hutscape/palm/readme.md

# Palm

> 🌴 Outdoor BLE-connected UV sensor keychain 🗝

Visit [hutscape.com/palm](https://hutscape.com/palm/) for more details.

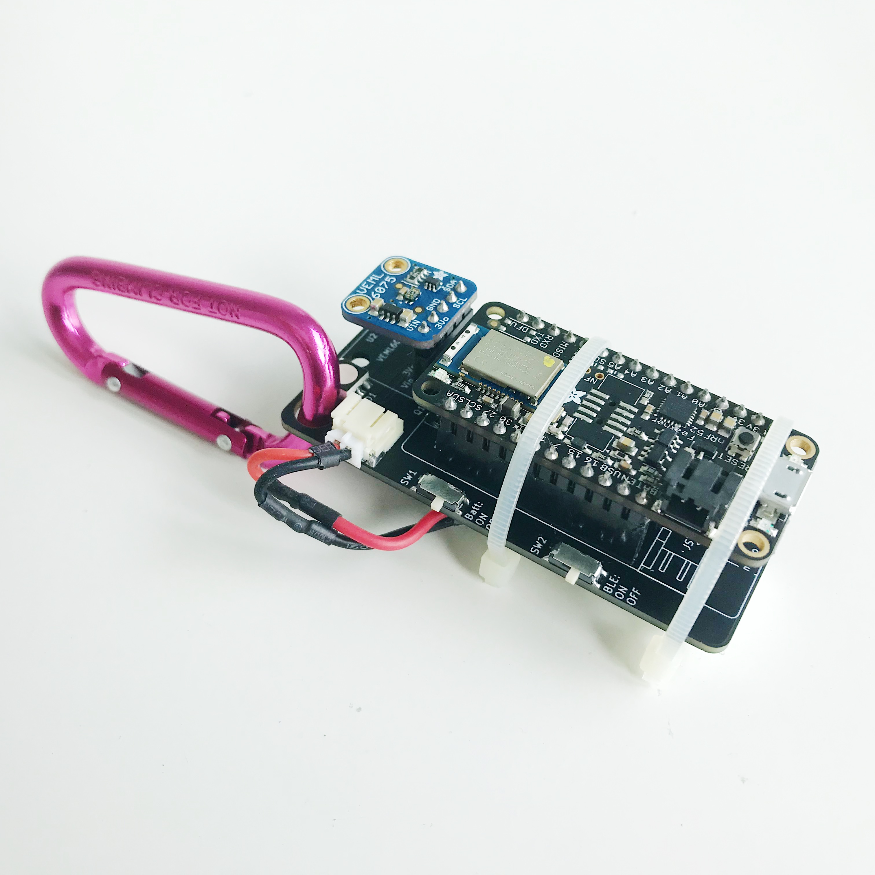
[picture p1: images/prototype/front.jpg]
