hutscape/palm/_code/web-ble.md

---
layout: code
title: Web BLE
description: Web BLE on Chrome browser is used to display the UV Index and Battery level on laptop
difficulty: medium
features:
  - UV
  - BLE
  - Chrome
  - browser
  - html
code: html
---
