hutscape/palm/images/code/demo-console.png

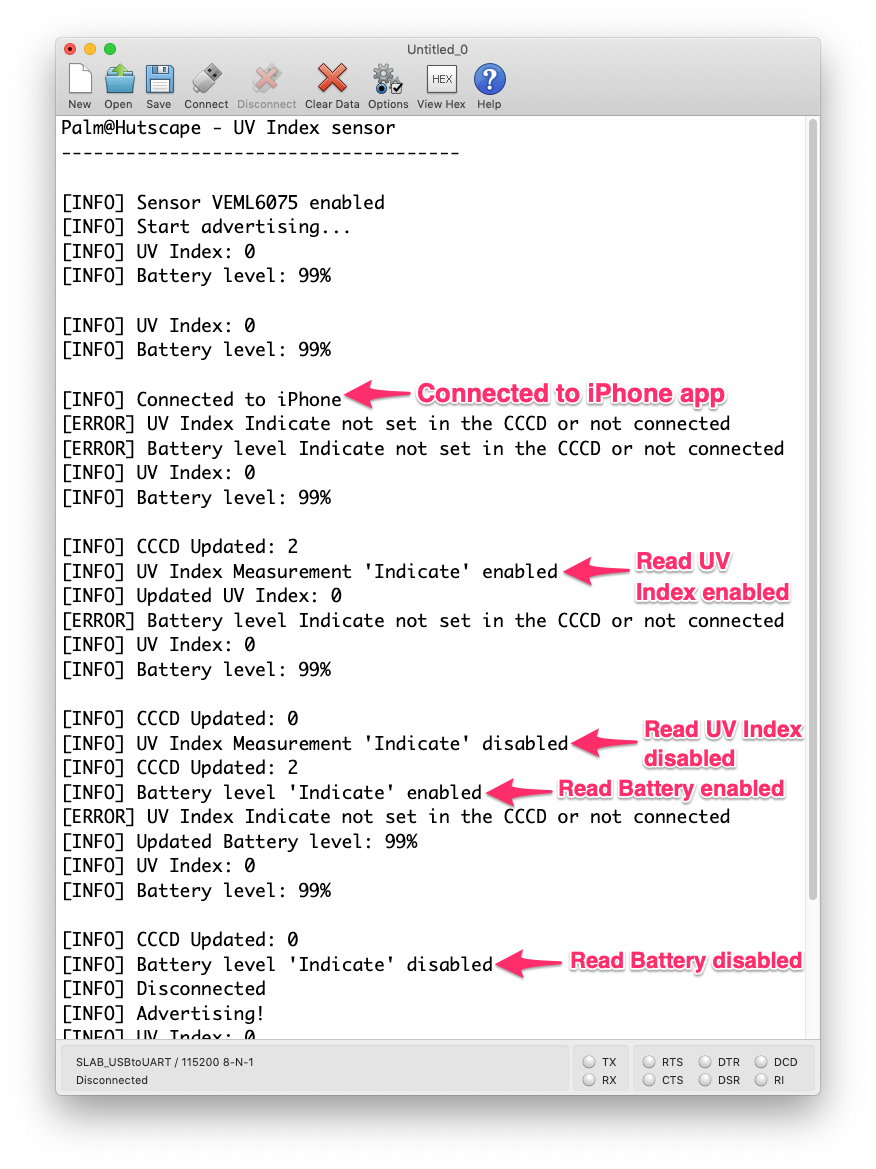
images/code/demo-console.png
