hutscape/palm/images/pcb/3dview-back.png

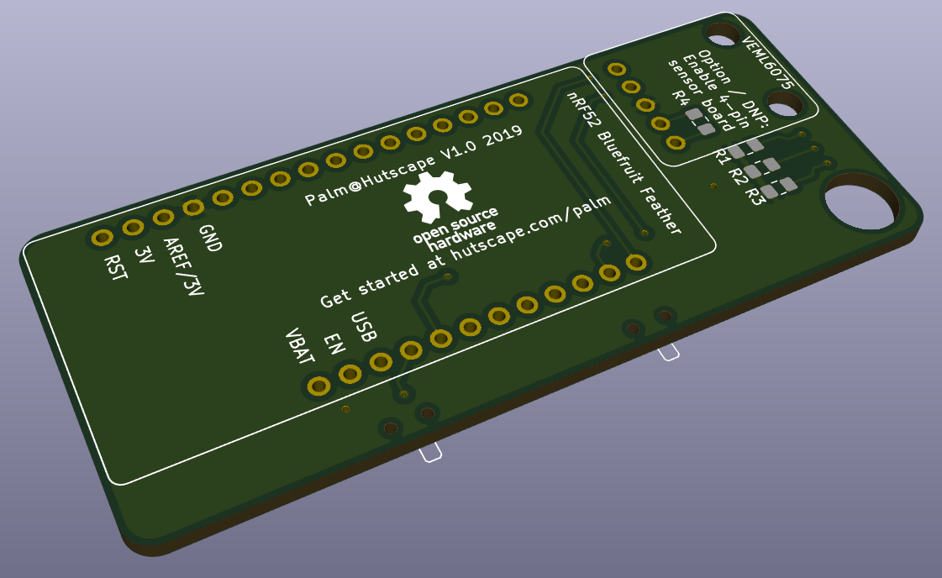
images/pcb/3dview-back.png
