hutscape/palm/images/pcb/layout-back.png

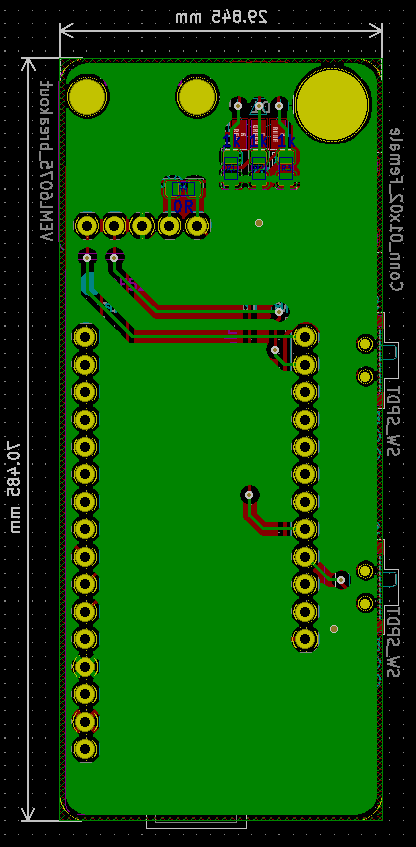
images/pcb/layout-back.png
