hutscape/palm/images/pcb/schematic.png

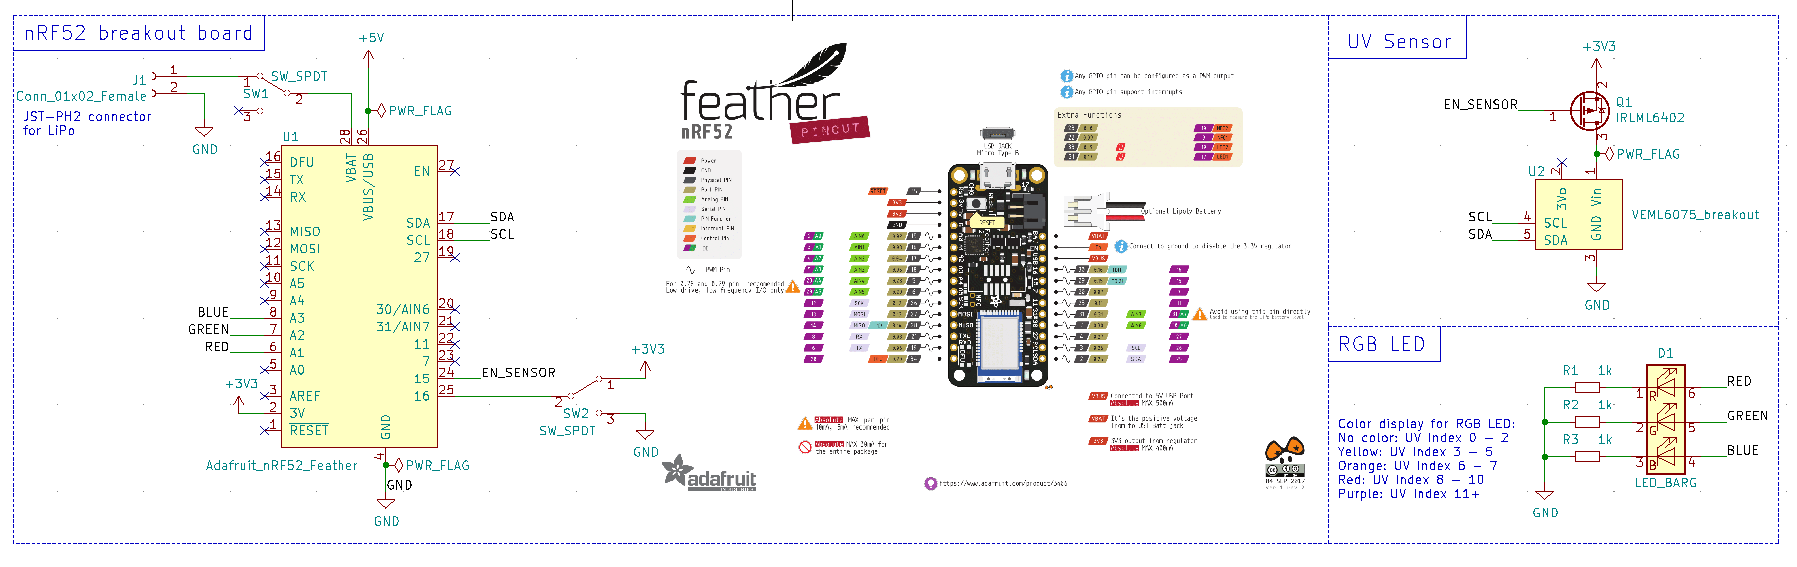
images/pcb/schematic.png
