hutscape/palm/images/power/power_tree.png

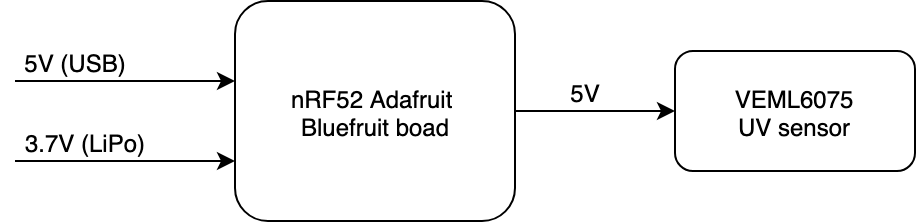
images/power/power_tree.png
