hutscape/palm/images/prototype/back.jpg

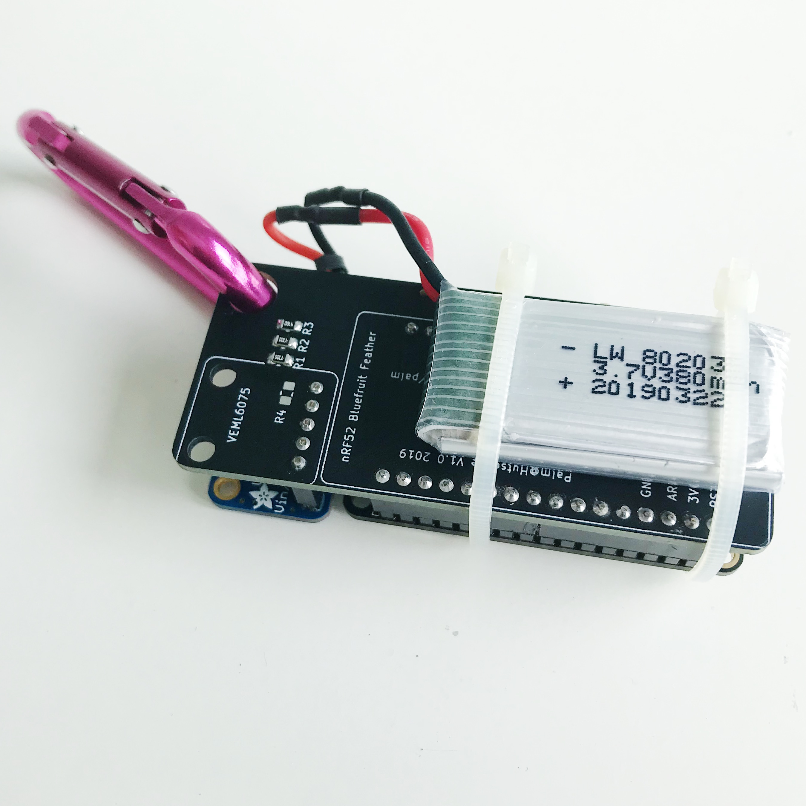
images/prototype/back.jpg
