hutscape/palm/images/prototype/side.jpg

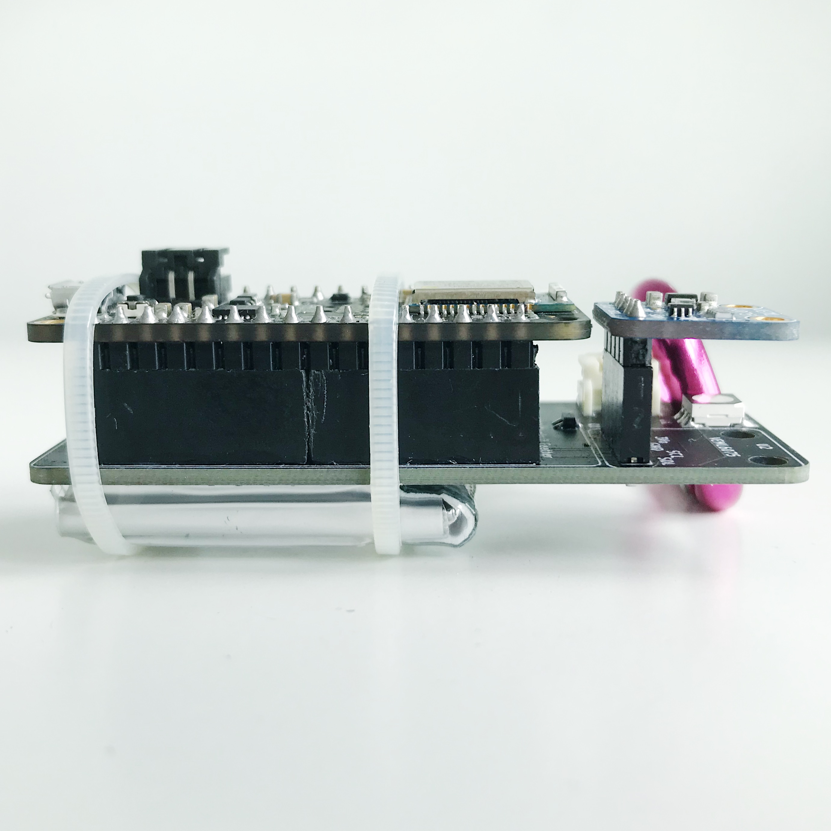
images/prototype/side.jpg
