hutscape/palm/images/prototype/top.jpg

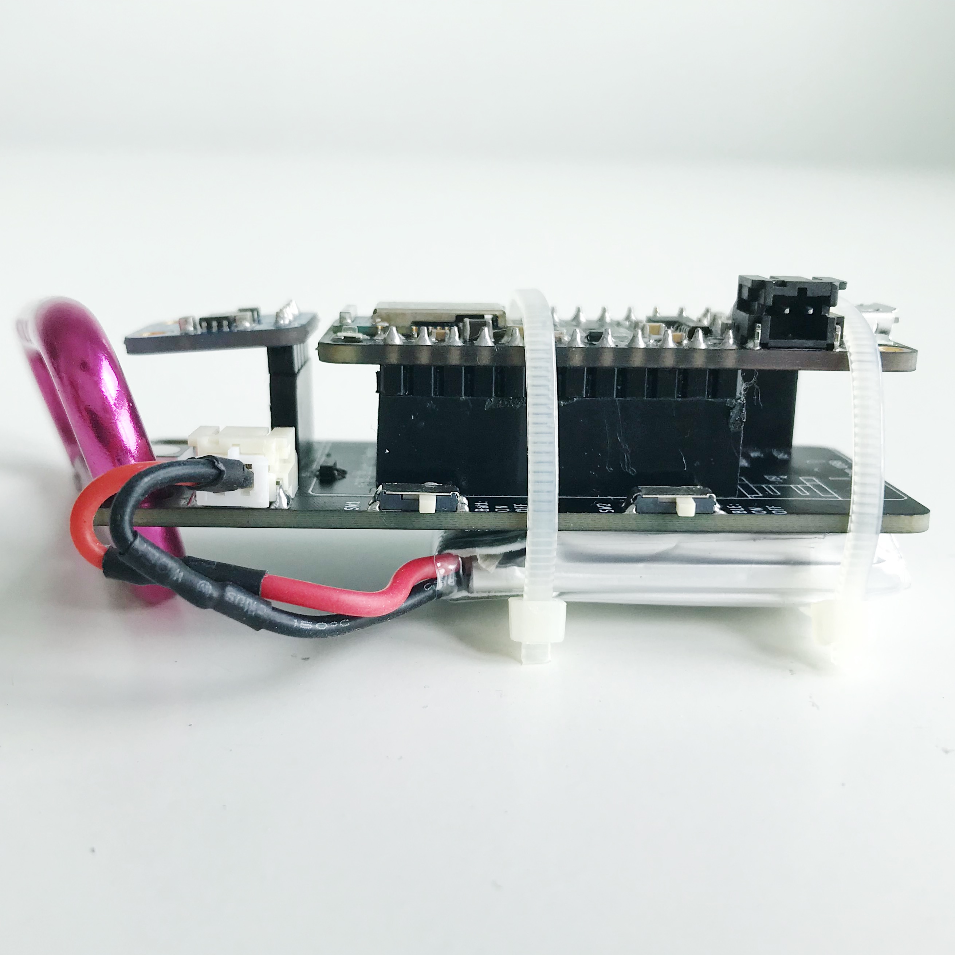
images/prototype/top.jpg
