hutscape/palm/start/step1.md

**Wire up the hardware components with [nRF52 Adafruit feather board](https://example.com), [VEML6075 sensor board](https://www.adafruit.com/product/3964) and LiPo battery. Turn on the switch for power and BLE.**

Schematic

Prototype
