hutscape/palm/start/step2.md

Flash the firmware onto the `nRF52` board to display UV Index and battery level.

Serial console for firmware
