hutscape/palm/start/step3.md

See the UV and battery level values on the [nRF Connect iPhone app](https://itunes.apple.com/sg/app/nrf-connect/id1054362403?mt=8)

iOS app detect
iOS app GATT Services
