hutscape/palm/_code/test.md

---
layout: code
title: Test with iOS client
description: Use the nRF Connect iPhone app to view the exact UV Index levels
difficulty: medium
features:
  - UV
  - BLE
  - iOS
images:
  console: test-console.png
---

<p class="subtitle is-4">Use the <a href="https://itunes.apple.com/sg/app/nrf-connect/id1054362403?mt=8">nRF Connect iPhone app</a> to view the exact UV Index levels.</p>
<div class="columns is-desktop">
  <div class="column">
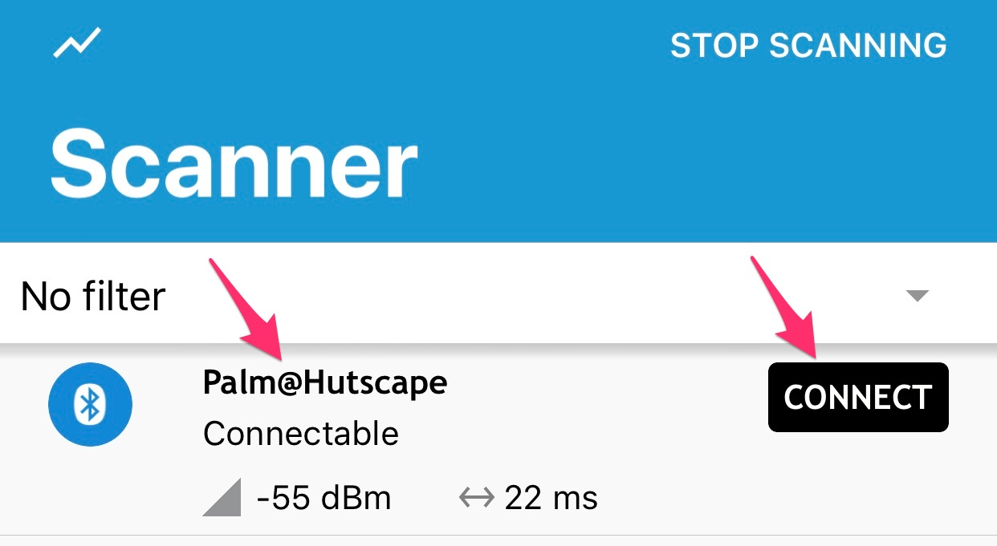
[picture p18: images/code/ios-detect.jpg]
iOS detect BLE device
    
  </div>
  <div class="column">
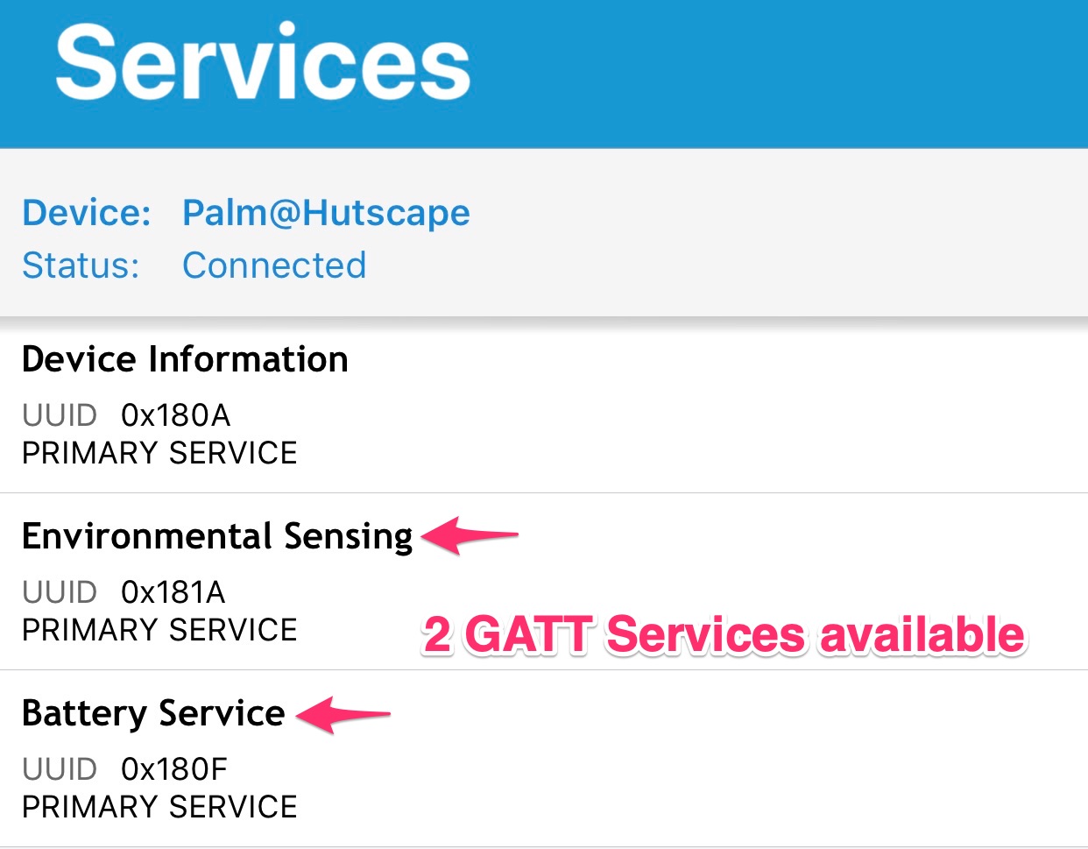
[picture p19: images/code/ios-services.jpg]
iOS detect GATT services
    
  </div>
  <div class="column">
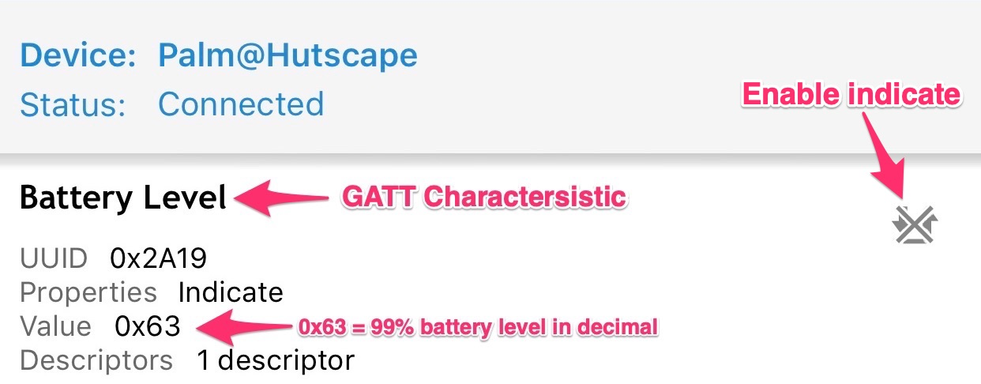
[picture p20: images/code/ios-characteristics-batt.jpg]
iOS GATT Characteristics Battery level
    
  </div>
  <div class="column">
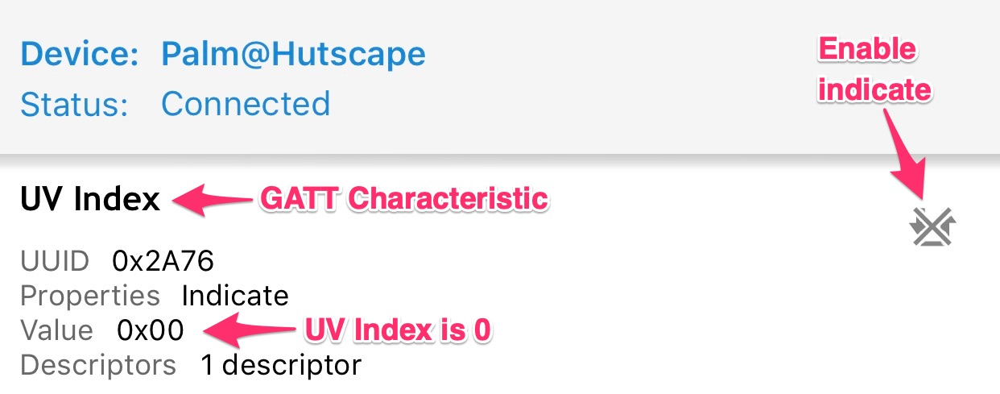
[picture p21: images/code/ios-characteristics-uv.jpg]
iOS GATT Characteristics UV Index
    
  </div>
</div>
