hutscape/palm/pcb/docs/schematic.pdf

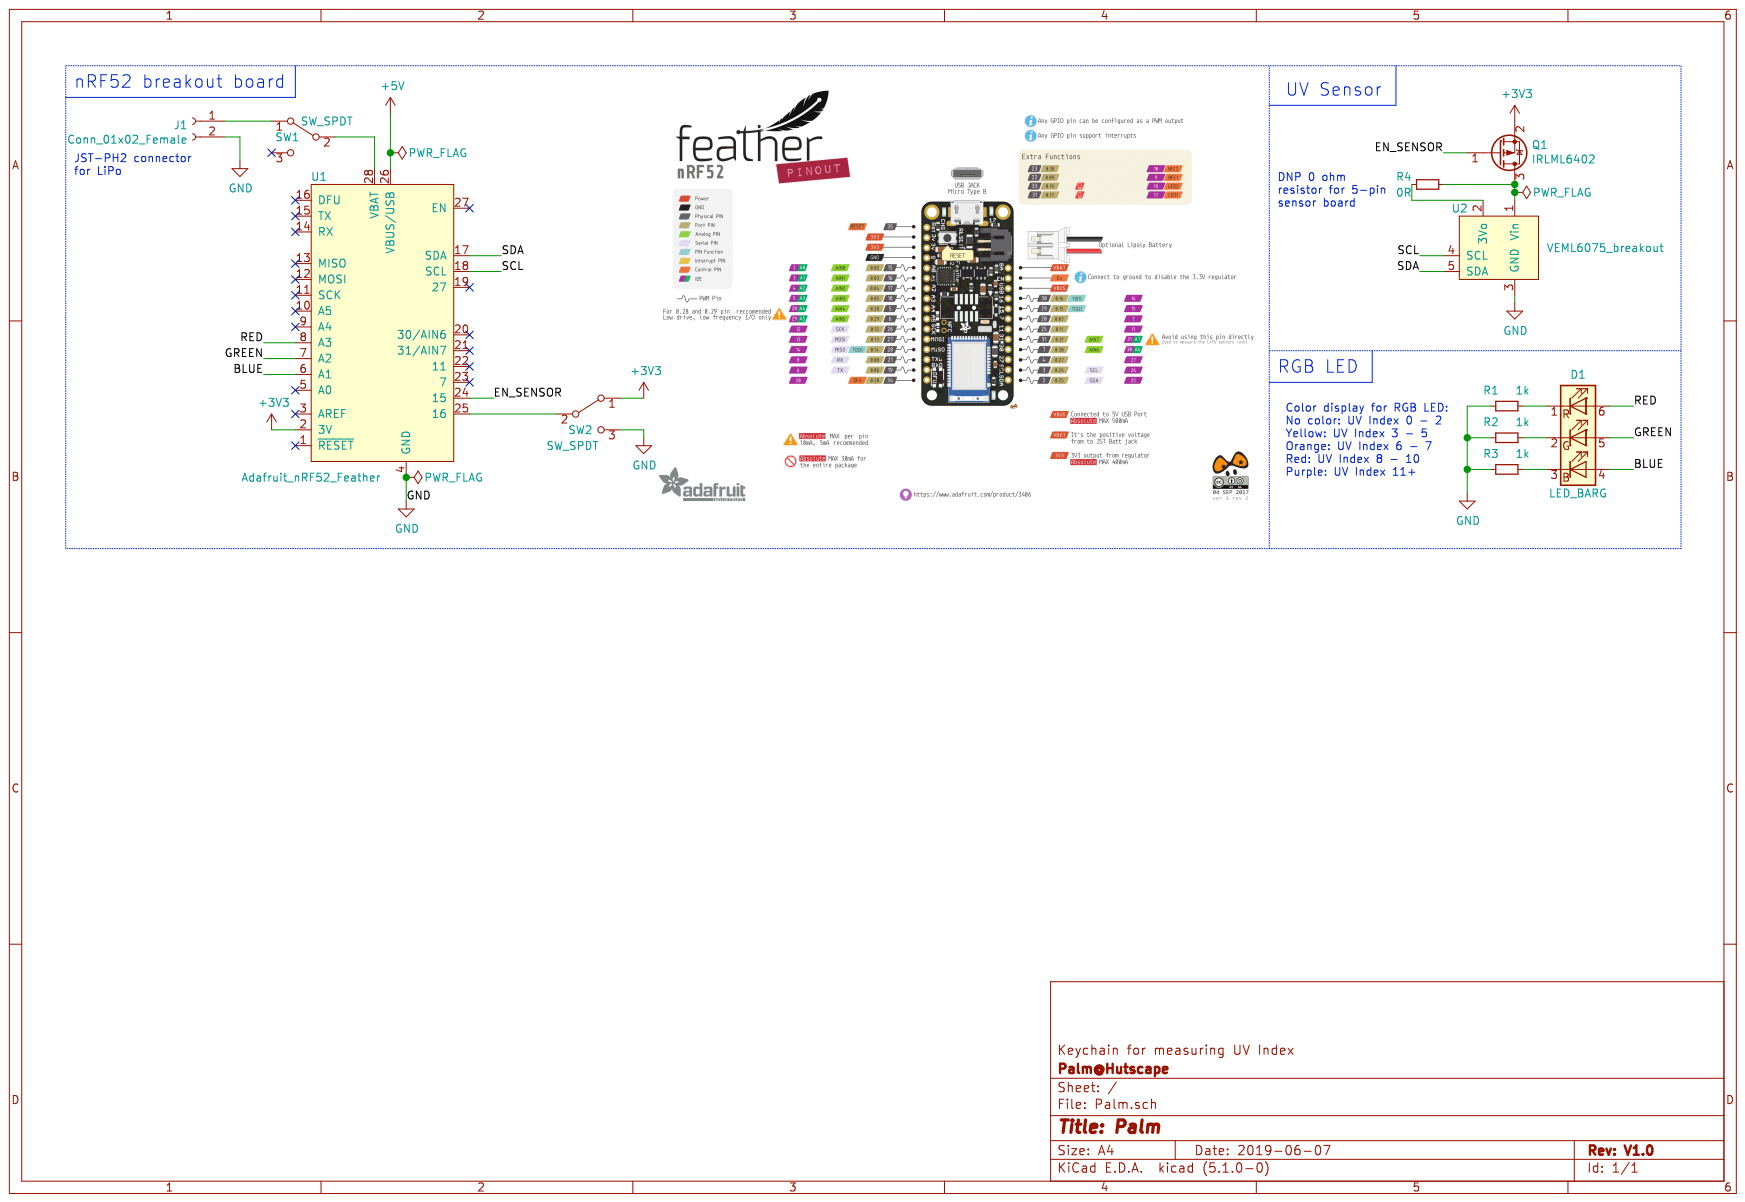
[picture p23: page 1]
