hutscape/palm/pcb/Palm.kicad_pcb

## KiCad design pcb/Palm.kicad_pcb (2019-11-18)

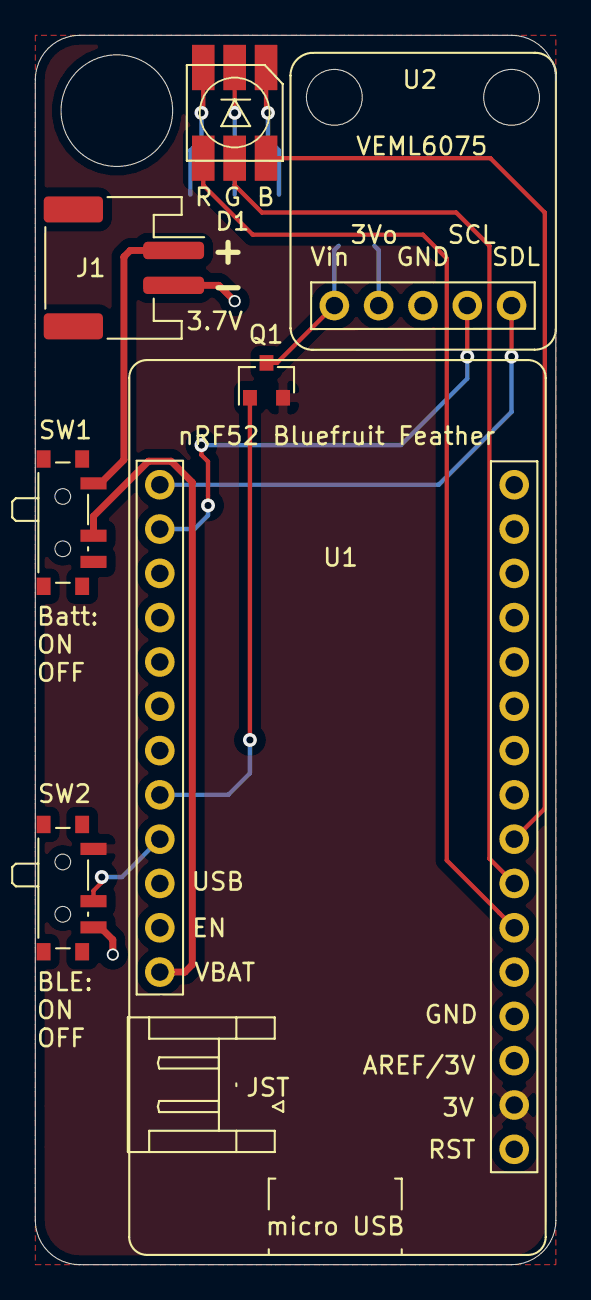
[picture p35: board Palm.kicad_pcb from above]

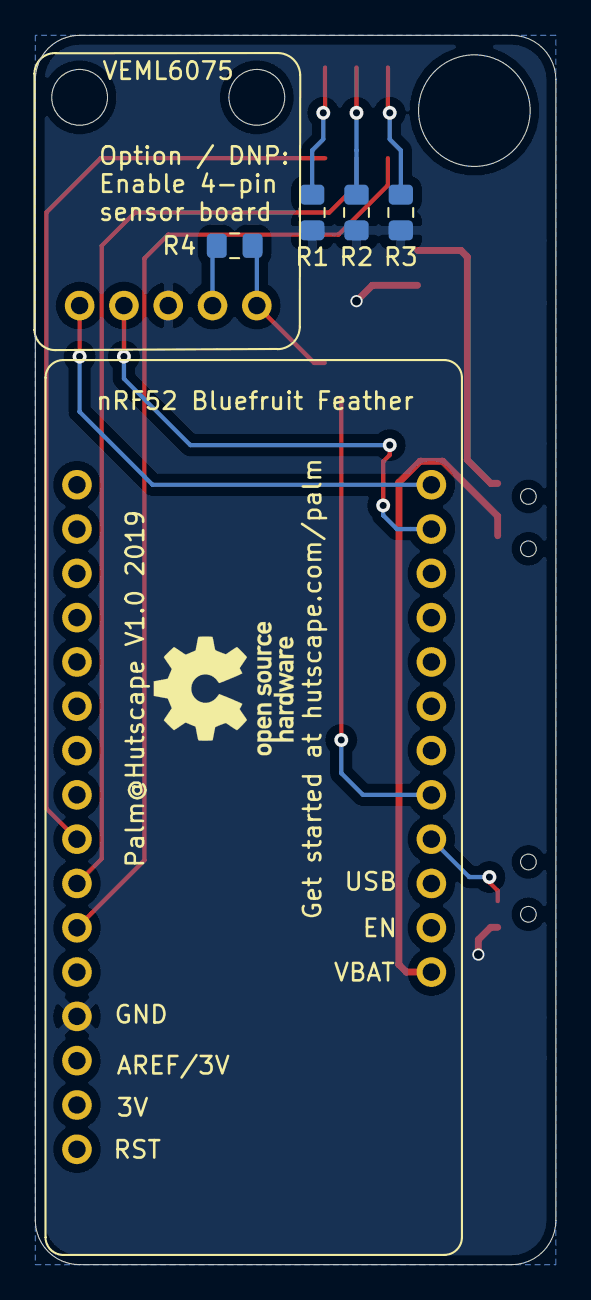
[picture p36: board Palm.kicad_pcb from below]

Board: 2 copper layers, 29.8 x 70.5 mm, 11 parts (4 on the bottom side), 16 nets.

Parts:
D1: LED_BARG; LED_RGB_Cree-PLCC-6_5.5x5.5mm_P2.1mm
J1: Conn_01x02_Female; JST_PH_S2B-PH-SM4-TB_1x02-1MP_P2.00mm_Horizontal
Q1: IRLML6402; SOT-23
R1, R2, R3: 1k; R_0805_2012Metric_Pad1.15x1.40mm_HandSolder
R4: 0R; R_0805_2012Metric_Pad1.15x1.40mm_HandSolder
SW1, SW2: SW_SPDT; SW_SPDT_PCM12
U1: Adafruit_nRF52_Feather; nRF52_Bluefruit_Adafruit_breakout_board
U2: VEML6075_breakout; VEML6075_breakout_board

Connections:
+3V3: Q1.2, SW2.1, U1.2
/BLUE: D1.4, U1.6
/EN_SENSOR: Q1.1, U1.24
/GREEN: D1.5, U1.7
/RED: D1.6, U1.8
/SCL: U1.18, U2.4
/SDA: U1.17, U2.5
GND: J1.2, R1.2, R2.2, R3.2, SW2.3, U1.4, U2.3
unnamed: D1.1, R1.1
unnamed: D1.2, R2.1
unnamed: D1.3, R3.1
unnamed: J1.1, SW1.1
unnamed: Q1.3, R4.1, U2.1
unnamed: R4.2, U2.2
unnamed: SW1.2, U1.28
unnamed: SW2.2, U1.25
