hutscape/palm/(commit log)

2019-04-02 [idea] Add research on sensors, power and mcu
2019-04-03 [docs] Add more explaination on the use case and sensors
2019-04-03 [docs] Change sensor to Si7021
2019-04-03 [docs] Add notes on the sensor value display
2019-04-11 Add hello world code for VEML6075 UV sensor
    [Palm.kicad_pcb, Palm.sch]
2019-04-11 Add blinky hello world with Adafruit nRF52 Bluefruit breakout board
2019-04-12 [prot] Add hello world code for UV sensor with nRF52 board
    [Palm.sch]
2019-04-13 [prot] Display UV values
    [Palm.sch]
2019-04-14 [docs] Add reference to read LiPo battery voltage
2019-04-14 [prot] Display UV sensor values with a LiPo
    [Palm.sch]
2019-04-15 [docs] Add chips inside SHARP display breakout board
2019-04-16 [prot] Connect second sensor
    [Palm.sch]
2019-04-16 [prot] Add images for the prototype hardware and console
2019-04-17 [prot] Use struct to read all sensor values
2019-05-14 [docs] Use only UV index sensor
2019-05-23 [docs] Add power calculation references
2019-05-23 [docs] Calculate power consumption in advertising and transmission mode
2019-05-24 [design] Add parameters for online power simulator
2019-05-25 [design] Add more info about nRF52's power consumption
2019-05-25 [design] Add more notes on estimated battery life and potential batteries
2019-05-27 Add mechanical dimensions for LiPo battery
2019-05-28 [design] Add RGB LED to indicate UV Index
    [Palm.sch]
2019-05-28 [design] Add resistors to RGB LED
    [Palm.sch]
2019-05-28 [design] Add power tree schematic and state machine diagram
2019-05-29 [design] Add new firmware with RGB LED on-board
2019-06-02 [design] Add 2 switches to on/off power and airplane mode
    [Palm.sch]
2019-06-02 [design] Add P-channel MOSFET switch and RGB LED
    [Palm.sch]
2019-06-03 [design] Update kicad library
2019-06-05 [design] Add information on vendor, manufacturer, part no, package
    [Palm.sch, bill_of_materials.csv]
2019-06-05 [bom] Generate bill of materials
    [Palm.sch, bill_of_materials.csv]
2019-06-05 [bom] Fix generated BOM format
    [bill_of_materials.csv]
2019-06-05 [bom] Add more logic to creating vendor links in BOM
    [bill_of_materials.csv]
2019-06-05 [bom] Add calculation for grand total cost
    [bill_of_materials.csv]
2019-06-05 [bom] Add category in BOM generation
    [Palm.sch, bill_of_materials.csv]
2019-06-07 [footprint] Associate nRF52 breakbout board with symbol and footprint
    [Palm.sch]
2019-06-07 [footprint] Update KiCad library with nRF52 breakout board footprint layout
2019-06-07 [footprint] Associate all symbols with footprint
    [Palm.sch]
2019-06-08 [footprint] Layout all footprints
    [Palm.kicad_pcb, Palm.sch]
2019-06-08 [footprint] Update footprint library
2019-06-08 [design] Update kicad library link
2019-06-08 [footprint] Add rats net
    [Palm.kicad_pcb]
2019-06-09 [footprint] Add back Cu zone with GND
    [Palm.kicad_pcb]
2019-06-09 [footprint] Link SDA/SCL and RGB LED tracks
    [Palm.kicad_pcb, Palm.sch]
2019-06-09 [footprint] Complete footprint layout
    [Palm.kicad_pcb]
2019-06-11 [footprint] Update footprint layout
    [Palm.kicad_pcb]
2019-06-12 [design] Add 0ohm resistor for sensor board option
    [Palm.sch]
2019-06-12 [bom] Re-generate BOM after adding 1 0R
    [Palm.sch, bill_of_materials.csv]
2019-06-12 [footprint] Generate gerbers
    [Palm-B_Cu.gbr, Palm-B_Mask.gbr, Palm-B_Paste.gbr, Palm-B_SilkS.gbr, Palm-Edge_Cuts.gbr, Palm-F_Cu.gbr, Palm-F_Mask.gbr, Palm-F_Paste.gbr]
2019-06-14 [docs] Add progress on BOM and others
2019-06-14 [docs] Fix markdown hyperlink brackets
2019-06-21 [bom] Update JST PH2 connector body orientation from straight to right angle
    [Palm.sch, bill_of_materials.csv]
2019-06-30 [footprint] Add more silkscreen annotations
    [Palm.kicad_pcb]
2019-07-02 [test] Add initial test for RGB LED colors on OCB integration
2019-07-02 [test] Add test for enabling, connecting and reading UV sensor
2019-07-02 [test] Add a todo task to disable sensor from pin
2019-07-02 [test] Add test for MOSFET to enable or disable the sensor
2019-07-03 [test] Measure UV Index in a loop and display LED color
2019-07-04 [test] Turn off and on the MOSFET with delays
2019-07-04 [si] Final firmware on PCB
2019-07-08 [docs] Fix power tree and add lessons learnt
2019-07-10 [design] Remove red LED toggling
2019-07-10 [design] Turn on/off BLE based on the enable wireless pin
2019-07-16 [docs] Add BOM
    [bill_of_materials.csv]
2019-07-16 [docs] Style power page
2019-07-18 [docs] Add prototype images
2019-07-19 [docs] Remove BOM columns
    [bill_of_materials.csv]
2019-07-21 [docs] Update BOM column
2019-07-22 [docs] Add money.js to convert BOM cost from SGD to USD
2019-07-22 [docs] Add BOM layout code in a common submodule
2019-07-23 [design] Add battery level code in firmware
2019-07-23 [design] Display GATT Service and characteristics for battery level
2019-07-24 [docs] Fix BOM
    [bill_of_materials.csv]
2019-07-29 [docs] Add 5 days for battery life
2019-07-29 [docs] Add more info on power
2019-08-01 [docs] Add space in BOM vendors
2019-08-01 [docs] Hide iBOM on touch devices
2019-08-07 [software] Add filter for detecting BLE device prefix name
2019-08-07 [docs] Add currency conversion for unit cost and total BOM cost
2019-08-16 [docs] Update common kicad library
2019-08-21 [docs] Add BOM iterator
2019-09-05 [docs] Generate BOM info automatically
2019-09-09 [docs] Move power tree schematic to under power page
2019-09-16 [docs] Update BOM format
2019-09-17 [bom] Add DNP column for BOM and Interactive HTML BOM
    [Palm.sch]
2019-09-18 [docs] Move power diagrams to power folder
2019-09-19 [docs] Improve BOM page
2019-10-11 feat: add sorting and searching for bom
2019-10-12 feat: tweak BOM column header and serial column
2019-10-24 feat: change footprint to layout naming
2019-10-28 feat: add download buttons on start page
2019-10-28 feat: add button link for gerber files
2019-11-04 fix: add gerber file download buttons
2019-11-07 feat: add notes for BOM column
2019-11-11 chore: update git submodules for scripts and bom
2019-11-18 chore: update submodules with global and project specific symbols and footprints
    [Palm.kicad_pcb, Palm.sch]
2019-11-28 chore: update KiCad 5.1.5
2021-03-18 chore: update arduino-cli
2021-06-26 chore: updgrade dependancies
    [bill_of_materials.csv]
2021-08-23 refactor: combine design, power and mechanical into design
2021-09-10 fix: reset fonts after inserting iBom
2022-01-08 refactor: organize power section
2022-04-20 refactor: make a parent data node for download buttons
2022-04-21 refactor: remove gerber_url to link to GitHub releases page
    [Palm-B_Cu.gbr, Palm-B_Mask.gbr, Palm-B_Paste.gbr, Palm-B_SilkS.gbr, Palm-Edge_Cuts.gbr, Palm-F_Cu.gbr, Palm-F_Mask.gbr, Palm-F_Paste.gbr]
2022-04-21 "refactor: seperate BOM page into more partials"
2022-05-18 "feat: add 18650 battery 3D model to KiCad library"
2022-05-19 "feat: add stub antenna 3D model to KiCad library"
2022-05-19 "feat: add /case layout for projects with enclosure designs"
2022-07-21 refactor: rename hardware layout to pcb
2022-07-21 refactor: rename directory from hardware to pcb
    [Palm.kicad_pcb, Palm.sch]
2022-07-21 "fix: change link to code images"
    [demo.ino, test.ino]
2022-07-22 chore: move images from hardware to pcb directory
2022-07-25 feat: add 3d printed case photos
2024-02-26 feat: update submodules for unique SMT, DNP and TH BOM parts
2024-02-29 chore: update submodules to seperate /case page into sections
2024-02-29 chore: update submodules to display manufacturing params for case
2024-03-04 feat: display all prototype images until defined max_prototype_images
2024-03-15 chore: update submodules to display software bill of materials
2024-04-01 chore: update submodules to display manufactured PCBs
2024-04-11 feat: add a new power page
2024-04-11 docs (power): remove HTML and convert content to only markdown
2024-05-01 chore: update submodules to sync BOM stats with the manufacturer
2024-11-14 chore: update submodule to conditionally display edit button
